slogic3d-cloud/retro-cassette/JOURNAL.md

---
title: "retro-cassette"
github: "https://github.com/slogic3d-cloud/retro-cassette"
description: "a deko thing with an retro cassette which can play musik"
created_at: "2026-11-08"
total_time: "13h"
---

# November 8, 2026: Starting with research and schematic
<!-- fabricate:entry 2403 -->

Today I reseach about the things that i need and then i startet with the schematic.
I start with the PCB but can't finish it today so i have to do this tomorrow



**Total time spent: 3h 18m**

# November 9, 2026: Starting with the pcb
<!-- fabricate:entry 2501 -->

Today I start with the PCB and made it not so good so that I must delete the old version because of many mistakes.

The mistakes are:
-thin tracs 
-some problems wiht the GND
-reverse polarity with the LED

For today I quit than it cost me a lots of nerves.



**Total time spent: 4h 6m**

# November 10, 2026: Finishing the PCB and solving the issues
<!-- fabricate:entry 2566 -->

Today I finished the PCB.
Instead of making tracs from GND to GND, i made a GND-zone in the B.Cu-Layer which eliminated my problems with the GND.
The issue with the reverse polarity at the LED solved i also.
The thin trac problem solved i with my brother and he explained me how i made it right so he can go and can finshed the rest of the tracs.



**Total time spent: 4h 36m**

# November 11, 2026: Made the paperwork from the PCB
<!-- fabricate:entry 2630 -->

Today i made the paperwork from the PCB.
That means I exported the Bom.csv file and sorted the folder strukture.
Actually I have done a finale DRC and correct the errors. 
Generated the Gerber-Files and the .step so i can do tomorrow the case for that




**Total time spent: 1h**
