slogic3d-cloud/retro-cassette/ai-notes/zusammenfassung.md

# Stand & offene Punkte

## Stand (08.11.2026)
- ⏰ Privates Ziel Weihnachten (inoffiziell Geschenk) → PCB bis ~Ende November bestellen.
- Repo angelegt (leer) → Grundstruktur PCB/, CAD/, firmware/, ai-notes/, .gitignore.
- Interview Runde 1 erledigt (siehe kontext.md).

## Offen – Entscheidungen des Users
- [x] Lautsprecher: Stereo 2× 40 mm + 2× MAX98357A. Akku 4000 mAh (2×2000 parallel oder 1×4000).
- [ ] Lade-IC: BQ24074 vs. MCP73871 – ich prüfe JLC, dann Vorschlag
- [ ] USB-UART-Chip fürs Flashen (z. B. CH340C) + Auto-Reset
- [ ] Gehäuse/Rahmen-Aufbau, Kassetten-Optik
- [ ] Tier/Budget

## Offen – für mich
- [ ] BOM.csv-Vorlage, Preise nur echte, keine erfundenen LCSC-Nummern.
