slogic3d-cloud/retro-cassette/ai-notes/kontext-zusammenfassung.md

# Kontext – Kurzfassung
- Projekt: Retro-Kassetten-Bilderrahmen (Deko + Musik) für Hack Club Fabricate.
- User: 13–15 J., Deutsch, kurz, "mittel" erklären. KiCad 10, Fusion 360, Kobra 2 Neo (PLA).
- **Ich schreibe nichts in README.md/JOURNAL.md, designe kein PCB/CAD, schreibe Firmware nicht allein.**
- Nur Branch `main`. Design-/Geldentscheidungen per Popup fragen.
- Bisher: ESP32-WROOM-32E, Bluetooth (A2DP) + microSD-MP3 (Upload per WLAN), MAX98357A, 4 MX-Tasten,
  Akku + Dauerbetrieb USB (Power-Path-Lader), Rahmengröße frei.
- Details: kontext.md. Stand/ToDos: zusammenfassung.md. Mein Log: journal.md.
