slogic3d-cloud/retro-cassette/PCB/screenshots/pcb-3d.png

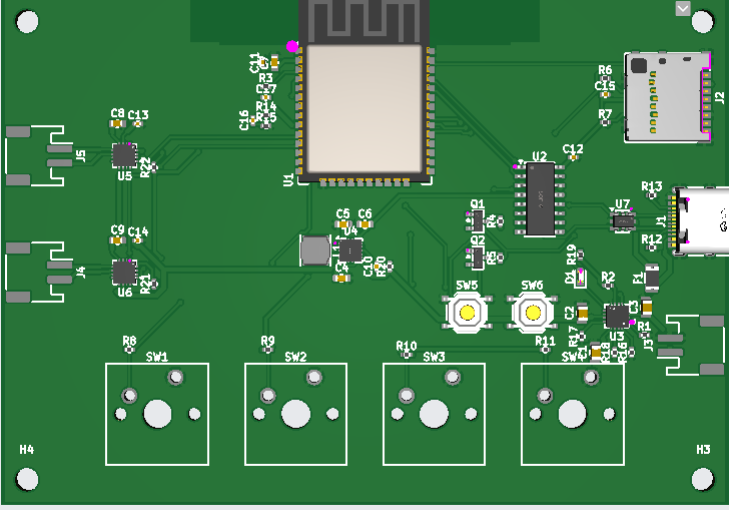
PCB/screenshots/pcb-3d.png
