slogic3d-cloud/retro-cassette/PCB/screenshots/pcb-back-B_Cu.png

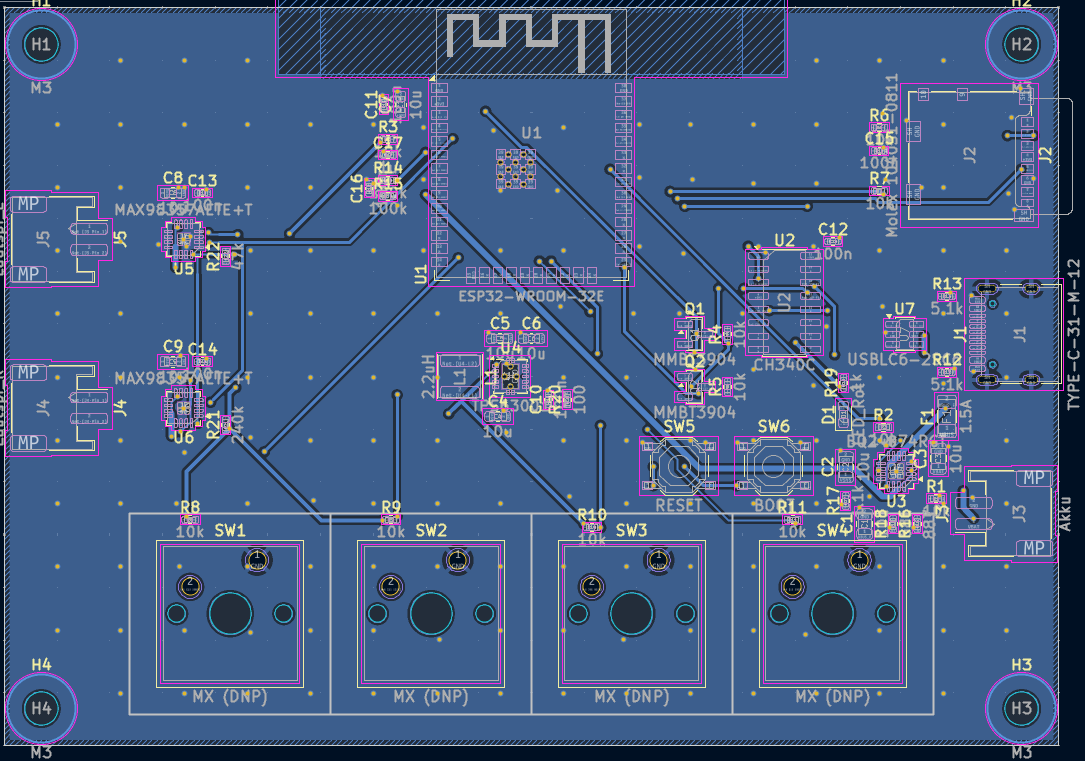
PCB/screenshots/pcb-back-B_Cu.png
