slogic3d-cloud/retro-cassette/PCB/screenshots/schematic.png

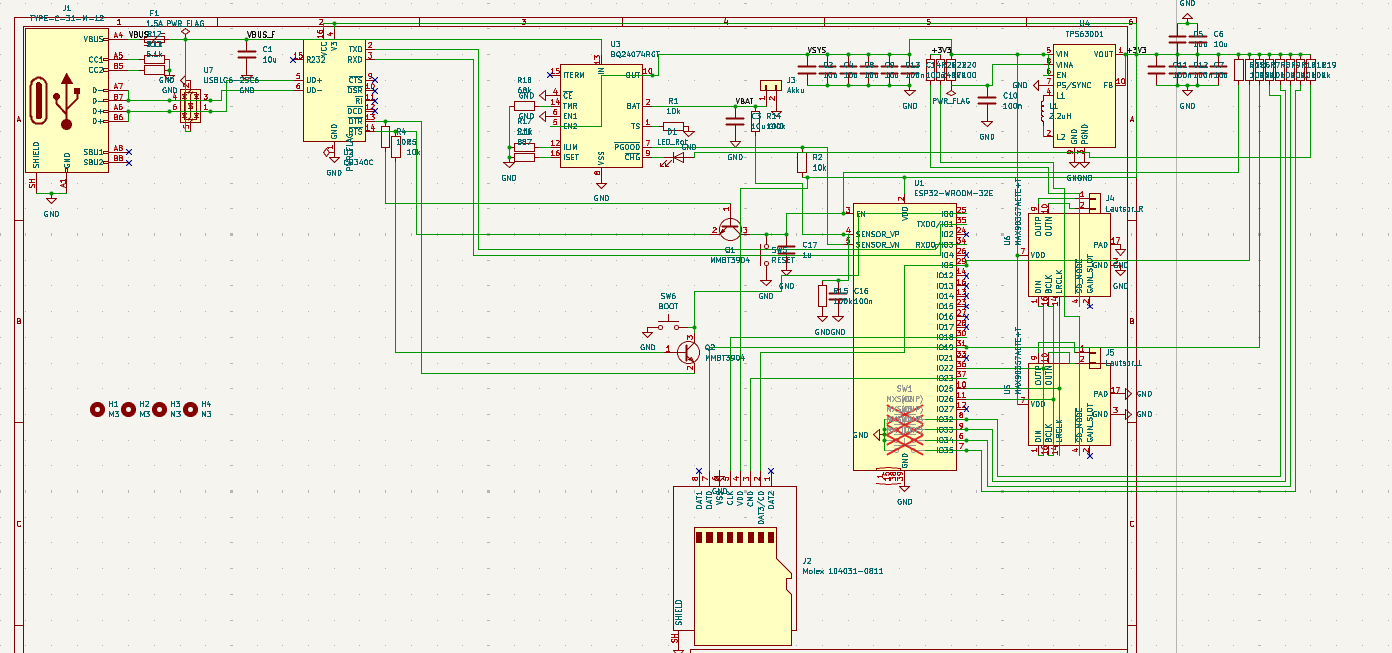
PCB/screenshots/schematic.png
