slogic3d-cloud/retro-cassette/BOM.csv

Ref | Teil | Wert | Footprint | Menge | LCSC | Link | Stueckpreis_USD | Versand | Notiz
U1 | ESP32-WROOM-32E-N8 | ESP32-WROOM-32E-N8 | RF_Module:ESP32-WROOM-32E | 1 | C701342 | https://www.lcsc.com/product-detail/C701342.html | 4.5662 | JLC PCBA | Extended; Modul -> JLC Standard PCBA
U2 | CH340C | CH340C | Package_SO:SOIC-16_3.9x9.9mm_P1.27mm | 1 | C84681 | https://www.lcsc.com/product-detail/C84681.html | 0.5447 | JLC PCBA | Extended; USB-Seriell zum Flashen
U3 | BQ24074RGTR | BQ24074RGTR | Package_DFN_QFN:VQFN-16-1EP_3x3mm_P0.5mm_EP1.6x1.6mm | 1 | C54313 | https://www.lcsc.com/product-detail/C54313.html | 2.118 | JLC PCBA | Extended; Lader mit Power-Path
U4 | TPS63001DRCR | TPS63001DRCR | Package_SON:Texas_DRC0010J_ThermalVias | 1 | C28060 | https://www.lcsc.com/product-detail/C28060.html | 1.6126 | JLC PCBA | Extended; Buck-Boost 3.3 V
U5 | MAX98357AETE+T | MAX98357AETE+T | Package_DFN_QFN:TQFN-16-1EP_3x3mm_P0.5mm_EP1.23x1.23mm | 1 | C910544 | https://www.lcsc.com/product-detail/C910544.html | 1.3084 | JLC PCBA | Extended; Audio links
U6 | MAX98357AETE+T | MAX98357AETE+T | Package_DFN_QFN:TQFN-16-1EP_3x3mm_P0.5mm_EP1.23x1.23mm | 1 | C910544 | https://www.lcsc.com/product-detail/C910544.html | 1.3084 | JLC PCBA | Extended; Audio rechts
U7 | USBLC6-2SC6 | USBLC6-2SC6 | Package_TO_SOT_SMD:SOT-23-6 | 1 | C2687116 | https://www.lcsc.com/product-detail/C2687116.html | 0.0478 | JLC PCBA | Extended; ESD USB
J1 | USB-C 16P | TYPE-C-31-M-12 | Connector_USB:USB_C_Receptacle_HRO_TYPE-C-31-M-12 | 1 | C165948 | https://www.lcsc.com/product-detail/C165948.html | 0.1868 | JLC PCBA | Extended
Q1 | MMBT3904 | MMBT3904 | Package_TO_SOT_SMD:SOT-23 | 1 | C20526 | https://www.lcsc.com/product-detail/C20526.html | 0.0117 | JLC PCBA | Basic; Auto-Reset
Q2 | MMBT3904 | MMBT3904 | Package_TO_SOT_SMD:SOT-23 | 1 | C20526 | https://www.lcsc.com/product-detail/C20526.html | 0.0117 | JLC PCBA | Basic; Auto-Reset
BAT1 | LiPo-Akku 3.7V 4000mAh 124065 (12x40x65 mm) mit PCM + JST PH 2.0 | 4000mAh | JST PH 2.0 an J3 | 1 |  | https://de.aliexpress.com/item/1005008755128961.html | 12.69 | AliExpress | Polung vor Einstecken messen (J3 Pin1 = +)
LS1-LS2 | Lautsprecher 3W 4 Ohm mit JST PH 2.0 (QUARKZMAN; 2er-Pack) | 3W 4R | JST PH 2.0 an J4/J5 | 1 Pack (2 Stk) |  | https://www.amazon.de/dp/B0DB1WQWXV | 8.49 | Amazon.de (Versand kostenlos) | Maße noch prüfen für Rahmen
W1 | JST PH 2.0 Verlaengerungskabel 2-Pin (VUNIVERSUM; 5 Paare) | 2-Pin | - | 1 Pack |  | https://www.amazon.de/dp/B08RCXD67Z | 5.49 | Amazon.de (Versand kostenlos) | Fuer rechten Lautsprecher (Kabel nur 10 cm); Variante 2 Pin waehlen
SW1-SW4 | MX-Klon Schalter braun/tactile 3-Pin (10er-Pack; 4 benutzt + 6 Reserve) | MX brown | Button_Switch_Keyboard:SW_Cherry_MX_1.00u_PCB | 1 Pack (10 Stk) |  | https://de.aliexpress.com/item/1005006188367905.html | 0.69 | AliExpress | DNP - selbst loeten
KC1-KC4 | Keycaps OEM R4 1U PBT blank schwarz MX-Stem (20er-Pack; 4 benutzt) | 1U OEM | - | 1 Pack (20 Stk) |  | https://www.amazon.de/dp/B0F1YQGJ35 | 10.99 | Amazon.de (Versand kostenlos) | Alternative: kleineres Pack oder selbst drucken (guenstiger)
SHIP-ALI | Versand AliExpress (Akku + MX-Schalter) | - | - | 1 |  | - | 6.34 | AliExpress | Versandkosten gesamt
JLC | PCB + PCBA (5 Stk.; Gerber + bom.csv + positions.csv) | - | - | 1 |  | https://jlcpcb.com | 105.43 | JLCPCB (inkl. 11.28 Versand; -8.95 Gutschein) | Merchandise 103.10 + Versand 11.28 - Coupon 8.95
