slogic3d-cloud/retro-cassette/PCB/production/bom.csv

Designator | Footprint | Quantity | Value | LCSC Part #
C1, C2, C3 | 0805 | 3 | 10u | C15850
C10, C11, C12, C13, C14, C15, C16 | 0402 | 7 | 100n | C1525
C17 | 0402 | 1 | 1u | C52923
C4, C5, C6, C7, C8, C9 | 0603 | 6 | 10u | C19702
D1 | 0603 | 1 | LED_Rot | C2286
F1 | 1206 | 1 | 1.5A | C135341
J1 | USB_C_Receptacle_HRO_TYPE-C-31-M-12 | 1 | TYPE-C-31-M-12 | C165948
J2 | microSD_HC_Molex_104031-0811 | 1 | Molex 104031-0811 | C585350
J3 | JST_PH_S2B-PH-SM4-TB_1x02-1MP_P2.00mm_Horizontal | 1 | Akku | C295747
J4 | JST_PH_S2B-PH-SM4-TB_1x02-1MP_P2.00mm_Horizontal | 1 | Lautspr_R | C295747
J5 | JST_PH_S2B-PH-SM4-TB_1x02-1MP_P2.00mm_Horizontal | 1 | Lautspr_L | C295747
L1 | L_Sunlord_SWPA4012S | 1 | 2.2uH | C96870
Q1, Q2 | SOT-23 | 2 | MMBT3904 | C20526
R1, R10, R11, R2, R3, R4, R5, R6, R7, R8, R9 | 0402 | 11 | 10k | C25744
R12, R13 | 0402 | 2 | 5.1k | C25905
R14, R15 | 0402 | 2 | 100k | C25741
R16 | 0402 | 1 | 887 | C4012675
R17 | 0402 | 1 | 1.1k | C25860
R18 | 0402 | 1 | 68k | C36871
R19 | 0402 | 1 | 1k | C11702
R20 | 0402 | 1 | 100 | C25076
R21 | 0402 | 1 | 240k | C138029
R22 | 0402 | 1 | 47k | C25792
SW1, SW2, SW3, SW4 | SW_Cherry_MX_1.00u_PCB | 4 | MX (DNP)
SW5 | SW_Push_1P1T_XKB_TS-1187A | 1 | RESET | C318884
SW6 | SW_Push_1P1T_XKB_TS-1187A | 1 | BOOT | C318884
U1 | ESP32-WROOM-32E | 1 | ESP32-WROOM-32E | C701342
U2 | SOIC-16_3.9x9.9mm_P1.27mm | 1 | CH340C | C84681
U3 | VQFN-16-1EP_3x3mm_P0.5mm_EP1.6x1.6mm | 1 | BQ24074RGT | C54313
U4 | Texas_DRC0010J_ThermalVias | 1 | TPS63001 | C28060
U5, U6 | TQFN-16-1EP_3x3mm_P0.5mm_EP1.23x1.23mm | 2 | MAX98357AETE+T | C910544
U7 | SOT-23-6 | 1 | USBLC6-2SC6 | C2687116
