slogic3d-cloud/retro-cassette/PCB/retro-kassete.step

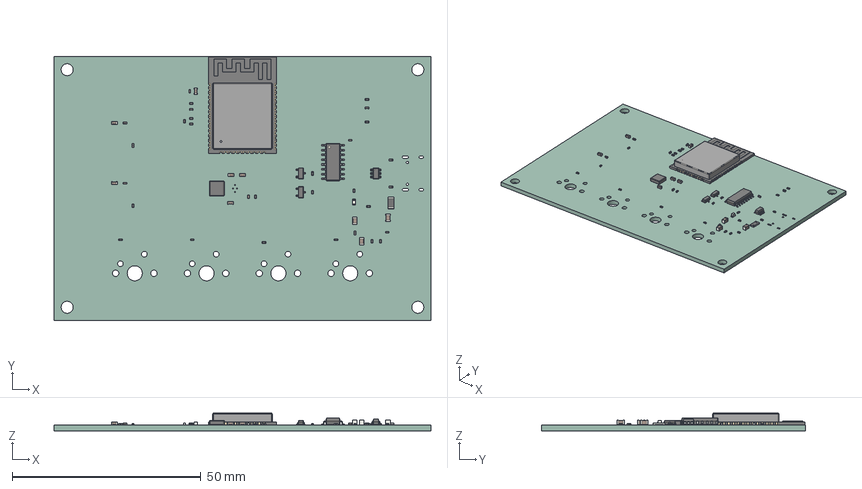
[picture p4: CAD file, 2026-11-11]
PCB/retro-kassete.step
100.0 x 70.0 x 4.70 mm
a6617152-8551-11ed-a139-00155d22e2d7_part
a66172ec-8551-11ed-a139-00155d22e2d7_part
a6617382-8551-11ed-a139-00155d22e2d7_part
SOT-23 x 2
R_0402_1005Metric x 22
ESP32-WROOM-32E
LED_0603_1608Metric
C_0603_1608Metric x 6
Fuse_1206_3216Metric
C_0402_1005Metric x 8
C_0805_2012Metric x 3
SOT-23-6
SOIC-16_3.9x9.9mm_P1.27mm
ret2445_PCB
