slogic3d-cloud/retro-cassette/PCB/retro-kassete.kicad_pcb

## KiCad design PCB/retro-kassete.kicad_pcb (2026-11-11)

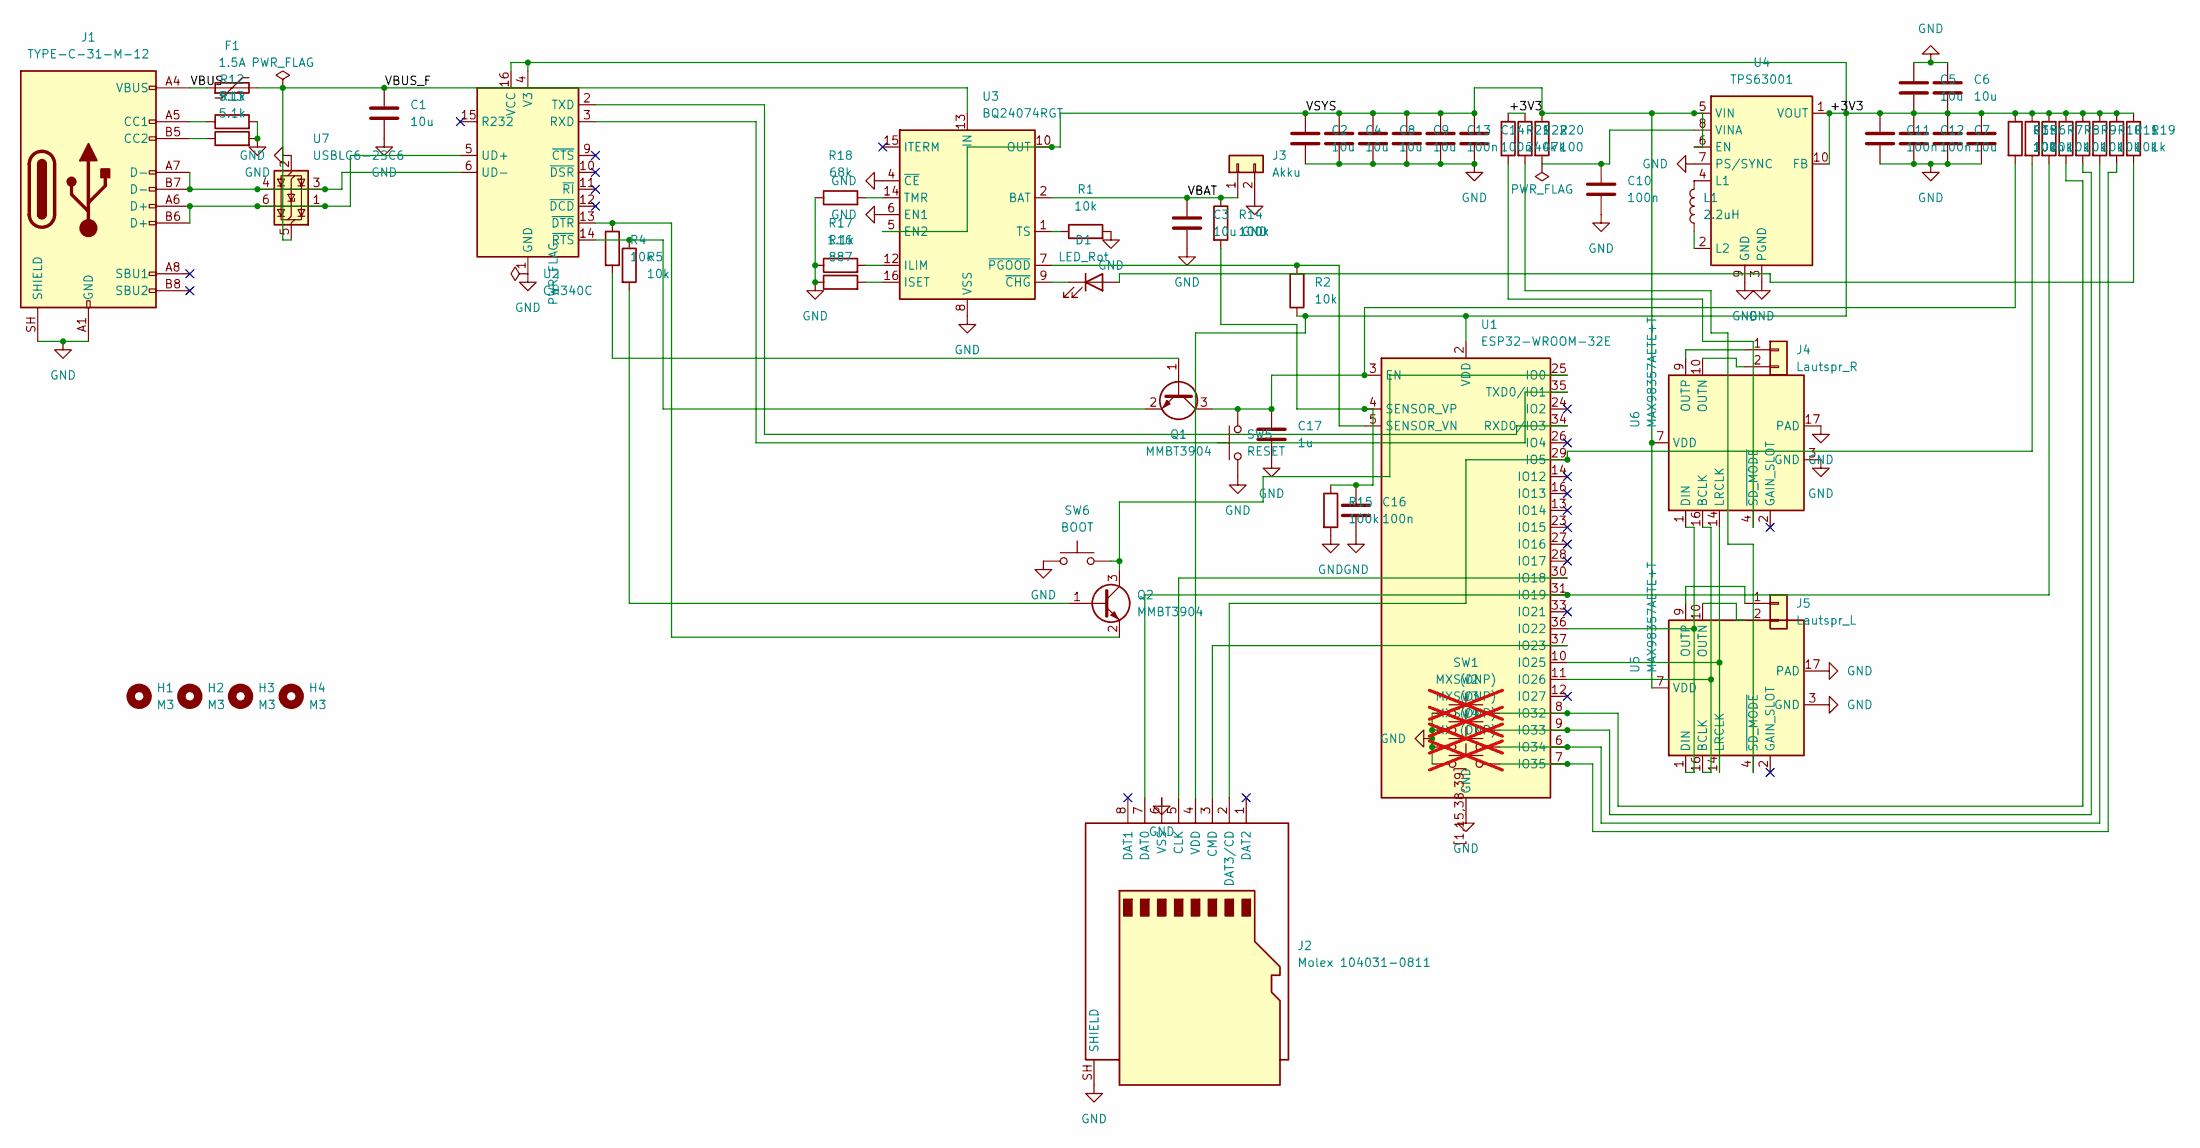
[picture p5: schematic retro-kassete.kicad_sch]

Parts:
C1, C2, C3: 10u; C_0805_2012Metric; LCSC C15850
C4, C5, C6, C7, C8, C9: 10u; C_0603_1608Metric; LCSC C19702
C10, C11, C12, C13, C14, C15, C16: 100n; C_0402_1005Metric; LCSC C1525
C17: 1u; C_0402_1005Metric; LCSC C52923
D1: LED_Rot; LED_0603_1608Metric; LCSC C2286
F1: 1.5A; Fuse_1206_3216Metric; LCSC C135341
H1, H2, H3, H4: M3; MountingHole_3.2mm_M3
J1: TYPE-C-31-M-12; USB_C_Receptacle_HRO_TYPE-C-31-M-12; LCSC C165948
J2: Molex 104031-0811; microSD_HC_Molex_104031-0811; LCSC C585350
J3: Akku; JST_PH_S2B-PH-SM4-TB_1x02-1MP_P2.00mm_Horizontal; LCSC C295747
J4: Lautspr_R; JST_PH_S2B-PH-SM4-TB_1x02-1MP_P2.00mm_Horizontal; LCSC C295747
J5: Lautspr_L; JST_PH_S2B-PH-SM4-TB_1x02-1MP_P2.00mm_Horizontal; LCSC C295747
L1: 2.2uH; L_Sunlord_SWPA4012S; LCSC C96870
Q1, Q2: MMBT3904; SOT-23; LCSC C20526
R1, R2, R3, R4, R5, R6, R7, R8, R9, R10, R11: 10k; R_0402_1005Metric; LCSC C25744
R12, R13: 5.1k; R_0402_1005Metric; LCSC C25905
R14, R15: 100k; R_0402_1005Metric; LCSC C25741
R16: 887; R_0402_1005Metric; LCSC C4012675
R17: 1.1k; R_0402_1005Metric; LCSC C25860
R18: 68k; R_0402_1005Metric; LCSC C36871
R19: 1k; R_0402_1005Metric; LCSC C11702
R20: 100; R_0402_1005Metric; LCSC C25076
R21: 240k; R_0402_1005Metric; LCSC C138029
R22: 47k; R_0402_1005Metric; LCSC C25792
SW1, SW2, SW3, SW4: MX (DNP); SW_Cherry_MX_1.00u_PCB; not fitted
SW5: RESET; SW_Push_1P1T_XKB_TS-1187A; LCSC C318884
SW6: BOOT; SW_Push_1P1T_XKB_TS-1187A; LCSC C318884
U1: ESP32-WROOM-32E; LCSC C701342
U2: CH340C; SOIC-16_3.9x9.9mm_P1.27mm; LCSC C84681
U3: BQ24074RGT; VQFN-16-1EP_3x3mm_P0.5mm_EP1.6x1.6mm; LCSC C54313
U4: TPS63001; Texas_DRC0010J_ThermalVias; LCSC C28060
U5, U6: MAX98357AETE+T; TQFN-16-1EP_3x3mm_P0.5mm_EP1.23x1.23mm; LCSC C910544
U7: USBLC6-2SC6; SOT-23-6; LCSC C2687116

Connections:
/+3V3: C5.2, C6.2, C7.1, C11.1, C12.1, C15.1, J2.4 (VDD), R2.1, R3.1, R6.1, R7.1, R8.1, R9.1, R10.1, R11.1, R19.1, R21.1, R22.1, U1.2 (VDD), U2.4 (V3), U2.16 (VCC), U4.1 (VOUT), U4.10 (FB)
/VBAT: C3.1, J3.1, R14.1, U3.2 (BAT), U3.3 (BAT)
/VBUS: F1.1, J1.A4 (VBUS), J1.A9 (VBUS), J1.B4 (VBUS), J1.B9 (VBUS)
/VBUS_F: C1.1, F1.2, U3.13 (IN), U7.5 (VBUS)
/VSYS: C2.1, C4.1, C8.1, C9.1, C13.1, C14.1, R20.1, U3.5 (EN2), U3.10 (OUT), U3.11 (OUT), U4.5 (VIN), U4.6 (EN), U5.7 (VDD), U5.8 (VDD), U6.7 (VDD), U6.8 (VDD)
GND: C1.2, C2.2, C3.2, C4.2, C5.1, C6.1, C7.2, C8.2, C9.2, C10.2, C11.2, C12.2, C13.2, C14.2, C15.2, C16.2, C17.1, J1.A1 (GND), J1.A12 (GND), J1.B1 (GND), J1.B12 (GND), J1.SH (SHIELD), J2.6 (VSS), J2.SH (SHIELD), J3.2, R1.2, R12.2, R13.2, R15.2, R16.1, R17.1, R18.1, SW1.1, SW2.1, SW3.1, SW4.1, SW5.1, SW6.1, U1.1 (GND), U1.15 (GND), U1.38 (GND), U1.39 (GND), U1.[1,15,38,39] (GND), U2.1 (GND), U3.4 (~CE), U3.6 (EN1), U3.8 (VSS), U3.17 (VSS), U4.3 (PGND), U4.7 (PS/SYNC), U4.9 (GND), U4.11 (PGND), U5.3 (GND), U5.11 (GND), U5.15 (GND), U5.17 (PAD), U6.3 (GND), U6.11 (GND), U6.15 (GND), U6.17 (PAD), U7.2 (GND)
unnamed: D1.2 (A), R19.2
unnamed: D1.1 (K), U3.9 (~CHG)
unnamed: J1.A5 (CC1), R12.1
unnamed: J1.B5 (CC2), R13.1
unnamed: J2.5 (CLK), U1.30 (IO18)
unnamed: J2.3 (CMD), U1.37 (IO23)
unnamed: J2.7 (DAT0), R7.2, U1.31 (IO19)
unnamed: J2.2 (DAT3/CD), R6.2, U1.29 (IO5)
unnamed: J4.1, U6.9 (OUTP)
unnamed: J4.2, U6.10 (OUTN)
unnamed: J5.1, U5.9 (OUTP)
unnamed: J5.2, U5.6 (NC), U5.10 (OUTN)
unnamed: Q1.1 (B), R4.2
unnamed: C17.2, Q1.3 (C), R3.2, SW5.2, U1.3 (EN)
unnamed: Q1.2 (E), R5.1, U2.14 (~RTS)
unnamed: Q2.1 (B), R5.2
unnamed: Q2.3 (C), SW6.2, U1.25 (IO0)
unnamed: Q2.2 (E), R4.1, U2.13 (~DTR)
unnamed: U1.36 (IO22), U5.1 (DIN), U6.1 (DIN)
unnamed: U1.10 (IO25), U5.14 (LRCLK), U6.14 (LRCLK)
unnamed: U1.11 (IO26), U5.16 (BCLK), U6.16 (BCLK)
unnamed: R8.2, SW1.2, U1.8 (IO32)
unnamed: R9.2, SW2.2, U1.9 (IO33)
unnamed: R10.2, SW3.2, U1.6 (IO34)
unnamed: R11.2, SW4.2, U1.7 (IO35)
unnamed: U1.34 (RXD0/IO3), U2.2 (TXD)
unnamed: R2.2, U1.5 (SENSOR_VN), U3.7 (~PGOOD)
unnamed: C16.1, R14.2, R15.1, U1.4 (SENSOR_VP)
unnamed: U1.35 (TXD0/IO1), U2.3 (RXD)
unnamed: J1.A6 (D+), J1.B6 (D+), U2.5 (UD+), U7.1 (I/O1), U7.6 (I/O1)
unnamed: J1.A7 (D-), J1.B7 (D-), U2.6 (UD-), U7.3 (I/O2), U7.4 (I/O2)
unnamed: R17.2, U3.12 (ILIM)
unnamed: R16.2, U3.16 (ISET)
unnamed: R18.2, U3.14 (TMR)
unnamed: R1.1, U3.1 (TS)
unnamed: L1.2, U4.4 (L1)
unnamed: L1.1, U4.2 (L2)
unnamed: C10.1, R20.2, U4.8 (VINA)
unnamed: R22.2, U5.4 (~SD_MODE)
unnamed: R21.2, U6.4 (~SD_MODE)

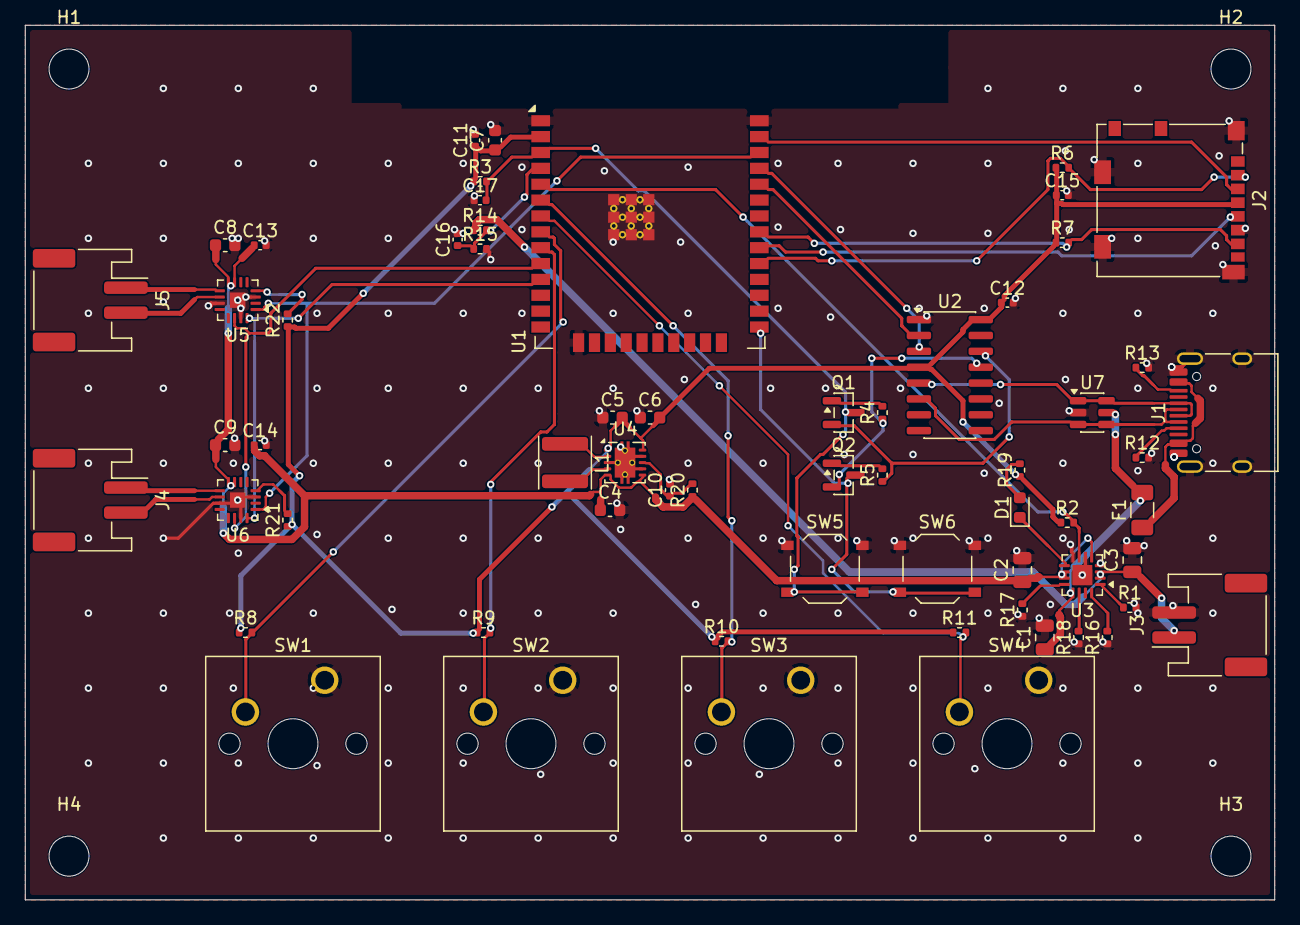
[picture p6: board retro-kassete.kicad_pcb from above]

Board: 2 copper layers, 100.0 x 70.0 mm, 66 parts (0 on the bottom side), 46 nets.
