slogic3d-cloud/retro-cassette/ai-notes/todo.md

# To-do (Stand 11.11.2026)

## Morgen (12.11.)
1. [ ] Repo öffentlich machen (GitHub → Settings → General → ganz unten "Change visibility" → Public)
2. [ ] Lautsprecher + Akku + MX-Schalter + Keycaps aussuchen (oder Claude um Vorschläge mit Links bitten) → Claude macht BOM.csv komplett
3. [ ] Screenshots für #fabricate: Schaltplan, PCB oben, PCB unten, 3D (Alt+3)
4. [ ] Design-Check in #fabricate posten (Text, Repo-Link, Screenshots, Gesamtkosten)
5. [ ] Grant-Ablauf in #fabricate / Docs klären – NICHTS selbst bezahlen
6. [ ] Rahmen in Fusion 360 anfangen (STEP importieren, Maße aus Claude-Chat / ai-notes/journal.md)
7. [ ] Journal-Eintrag auf Fabricate (nur echte Zeit, Bild)

## Danach
8. [ ] Feedback aus #fabricate umsetzen
9. [ ] Nach Freigabe: JLC bestellen (Gerber + BOM + CPL, PCBA Standard, 3D-Drehung prüfen, Global Standard Direct Line)
10. [ ] Rahmen fertig konstruieren + drucken (Kobra 2 Neo, PLA)
11. [ ] Firmware (PlatformIO): Tasten → Ton I2S → SD-MP3 → Bluetooth → WLAN-Upload
12. [ ] Zusammenbau + Test
13. [ ] README schreiben (User selbst): Beschreibung, Warum, Bilder, Screenshots, Pinout, BOM + Gesamtkosten, AI Disclosure, Lizenz (MIT)
14. [ ] Einreichen, Tier wählen
