slogic3d-cloud/retro-cassette/(commit log)

2026-11-08 Repo-Struktur, .gitignore und ai-notes anlegen
    - Ordner PCB/, CAD/, firmware/ (Fabricate-Struktur)
    - .gitignore: KiCad-Backups/Lockfiles, PlatformIO .pio, Plugin-Ordner .claude-flow/ und .swarm/
    - ai-notes/: Kontext und Interview-Ergebnisse
    Claude-Session: https://claude.ai/code/session_019isHHY68KyV6KtNnfuojkV
2026-11-08 ai-notes: Tastenbelegung, Lader BQ24074 und Audio-Amp festhalten
    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
2026-11-08 BOM.csv mit ersten geprüften JLC-Teilen anlegen
    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
    [BOM.csv]
2026-11-08 ai-notes: Datenblattwerte und Stückliste für den Schaltplan
    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
2026-11-08 ai-notes: Arbeitszeit, Netzliste nach Blöcken und PCB-Vorschlag festhalten
    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
2026-11-08 ai-notes: Journal-Arbeitsweise des Users festhalten
    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
2026-11-09 KiCad-Projekt (Schaltplan + erstes PCB-Layout) hochladen
    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
    [retro-kassete.kicad_pcb, retro-kassete.kicad_sch]
2026-11-09 KiCad-Projekt Version 2 (100x70 mm) hochladen
    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
    [retro-kassete.kicad_pcb, retro-kassete.kicad_sch]
2026-11-09 ai-notes: SD_MODE-Werte und Begründung festhalten
    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
2026-11-09 KiCad-Projekt: Zwischenstand neues PCB-Layout (100x100 mm)
    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
    [retro-kassete.kicad_pcb, retro-kassete.kicad_sch]
2026-11-09 Schaltplan: Lade-LED D1 richtig gepolt
    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
    [retro-kassete.kicad_sch]
2026-11-10 KiCad-Projekt Version 3: komplett geroutet bis auf GND-Füllung
    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
    [retro-kassete.kicad_pcb, retro-kassete.kicad_sch]
2026-11-11 KiCad-Projekt Version 4: GND-Zone gefüllt
    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
    [retro-kassete.kicad_pcb]
2026-11-11 PCB: fertiges Layout, Gerber, STEP und Fertigungsdateien hochladen
    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
    [bom.csv, designators.csv, positions.csv, retro-kassete.kicad_pcb, retro-kassete.kicad_sch, retro-kassete.step]
2026-11-11 PCB: Fertigungsdateien mit LCSC-Nummern neu exportiert
    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
    [bom.csv, positions.csv, retro-kassete.kicad_pcb]
2026-11-11 BOM: Akku hinzufügen
    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
    [BOM.csv]
2026-11-11 BOM: Lautsprecher hinzufügen
    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
    [BOM.csv]
2026-11-11 BOM: JST-PH-Verlängerung für Lautsprecher
    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
    [BOM.csv]
2026-11-11 BOM: MX-Schalter (vorläufig)
    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
    [BOM.csv]
2026-11-11 BOM: MX-Schalter Menge korrigiert (10er-Pack)
    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
    [BOM.csv]
2026-11-11 BOM: MX-Schalter-Typ ergänzt
    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
    [BOM.csv]
2026-11-11 BOM: Keycaps hinzufügen
    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
    [BOM.csv]
2026-11-11 BOM: Amazon-Versand kostenlos vermerkt
    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
    [BOM.csv]
2026-11-11 BOM: AliExpress-Versand
    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
    [BOM.csv]
2026-11-11 BOM: JLC-Angebot (PCB + Bestückung) eingetragen
    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
    [BOM.csv]
2026-11-11 PCB: Screenshots (3D, Vorder- und Rückseite)
    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
2026-11-12 PCB: Schaltplan-Screenshot
    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
